onyeijen/energyScheduler/(list of files, drawings)

Other design files:
simulation domestic energy scheduler.DSN
